ferrolho/rotary-inverted-pendulum/(list of files, cad)

Other CAD files:
meshes/motor plate.stl
meshes/base.stl
meshes/arm.stl
meshes/lid.stl
meshes/pendulum.stl
