ferrolho/rotary-inverted-pendulum/RotaryInvertedPendulum-arduino/TestHeartbeat/TestHeartbeat.ino

void setup()
{
    Serial.begin(115200);
    Serial.println("Test Heartbeat");
    pinMode(LED_BUILTIN, OUTPUT);
}

void loop()
{
    digitalWrite(LED_BUILTIN, HIGH);
    delay(100);
    digitalWrite(LED_BUILTIN, LOW);
    delay(100);
    digitalWrite(LED_BUILTIN, HIGH);
    delay(100);
    digitalWrite(LED_BUILTIN, LOW);
    delay(1000);
}
