ferrolho/rotary-inverted-pendulum/(commit log)

2024-05-12 Track STL files with Git LFS
2024-05-12 Add meshes (v2.2.0)
    [Rotary Inverted Pendulum - Base Bottom.stl, Rotary Inverted Pendulum - Base Top.stl, Rotary Inverted Pendulum - C-Clip.stl, Rotary Inverted Pendulum - Part 1.stl, Rotary Inverted Pendulum - Part 2.stl]
2024-05-12 Track "diagrams/**" with Git LFS
2024-05-12 Remove C-Clip mesh
    [Rotary Inverted Pendulum - C-Clip.stl]
2024-05-13 Add commands to start and stop the motor via UART
2024-05-13 Map the Xbox controller's A and B buttons for starting and stopping the motor
2024-05-13 Reorganise arduino and python folder structure
2024-05-14 Take joystick input as the motor velocity to be commanded
2024-05-14 Add serial command to retrieve the position of the pendulum from the Arduino
2024-05-14 [WIP] PID control (not working yet)
2024-05-16 Add Arduino libs as git submodules
    Add the 'AccelStepper' and 'Seeed_Arduino_AS5600' libraries.
    ```
    cd ~/git/Rotary\ Inverted\ Pendulum/RotaryInvertedPendulum-arduino/libs
    git submodule add https://github.com/waspinator/AccelStepper.git
    git submodule add https://github.com/Seeed-Studio/Seeed_Arduino_AS5600.git
    ```
2024-05-17 [WIP] PID control on the Arduino
2024-05-17 Update STL of part 2 of the mechanism
    [Rotary Inverted Pendulum - Part 2.stl]
2024-05-18 Update circuit diagrams and embed them in the README.md
2024-05-21 Improve Julia function that waits until the Arduino is ready
2024-05-22 Changes to PID control using Julia over the serial
    I cannot seem to get a main loop frequency above 100-ish Hertz over the serial... I tried increasing the baud rate to 2M and I also tried decreasing the length of bytes going across the serial by using command IDs instead of fully-written command names.
2024-08-23 Add Arduino script for testing the encoder
2024-08-23 Add Arduino sketch to test hearbeat
2024-08-23 Add Arduino sketch to test motor
2024-09-19 Update STL mesh files
    [Rotary Inverted Pendulum - Base Bottom.stl, Rotary Inverted Pendulum - Base Top.stl, Rotary Inverted Pendulum - Part 1.stl, Rotary Inverted Pendulum - Part 2.stl, arm.stl, base.stl, lid.stl, motor plate.stl]
2024-09-19 Update Arduino code
2024-09-19 Update circuit diagram for system without batteries
2024-09-19 Update circuit diagram image sizes in README.md
2026-09-14 add(hardware): circuit diagram with tmc2209
2026-09-15 add(hardware): circuit diagram with batteries and tmc2209
